VishalSharma0309/Inferno/README.md

# Welcome to Team Inferno DTU's official GitHub page
This page contains most of our code base for our 1st Martian Rover Prototype, A.R.G.U.S.

## Sub-Systems

### Drive System
### Robotic Arm
### Science Task
#### Autonomous Task

```
