VishalSharma0309/Inferno/Autonomous/sensors/moisture.ino

const int VAL_PROBE = 0; // Analog pin 0
const int MOISTURE_LEVEL = 250; // the value after the LED goes ON
 
void setup() {
    Serial.begin(9600);
}
 
void LedState(int state) {
    digitalWrite(13, state);
}
 
void loop() {
    int moisture = analogRead(VAL_PROBE);
 
    Serial.println(moisture);
 
    if(moisture > MOISTURE_LEVEL) {
        LedState(HIGH);
    } else   {
        LedState(LOW);
    }
    delay(100);
}
