VishalSharma0309/Inferno/(commit log)

2018-09-11 Create Robotic Arm Prototype (servo)
    It consists of inverse kinematics algorithm and basically instructs servo motors for base , shoulder and elbow accordingly.
2018-09-11 Create Serial Motor Test
    Serial Motor ;
    This includes the code for testing the motor. This motor is serial controlled i.e it accepts commands like p0 ( moves to position 0 without feedback) .
2018-10-14 Update Serial Motor Test
2018-10-14 Create Elbow Joint
    This code is used for elbow joint.
2018-10-14 Create Inverse kinematics code
2018-10-14 Update Elbow Joint
2018-10-14 Base motor lib
2018-10-24 Create 2 joint testing
2018-12-28 Create Gripper Wrist joint Code
2019-04-19 Script to set up RaspberryPi headlessly. Run this script after mounting rasbian image on a SD card
2019-07-02 Create sub roverdrive and sending serialcom to arduino
2019-07-02 Create arduino code for serialcom
